Marcus10110/wireless-led-controller/README.md

# wireless-led-pcb

Dirt Simple LED Controller.

ESP32 based.

Supports running from a single 18650 battery, or a barrel jack.

For 18650 operation, only 5V strips are supported.

For barrel jack operation, 5V, 12V, and 24V strips are supported.
