Marcus10110/wireless-led-controller/mech/template_outline.dxf

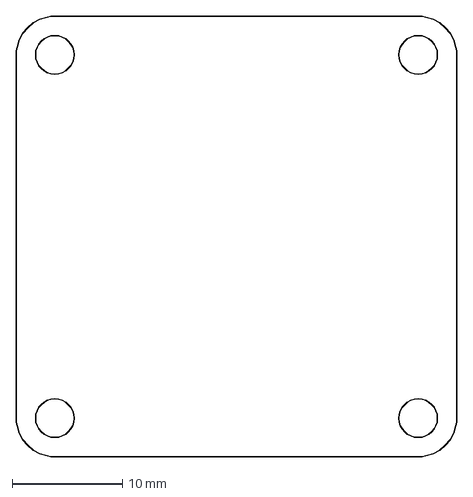
[picture p1: CAD file, 2024-07-03]
mech/template_outline.dxf
40.0 x 40.0 mm
