Marcus10110/wireless-led-controller/mech/template_40x40.dxf

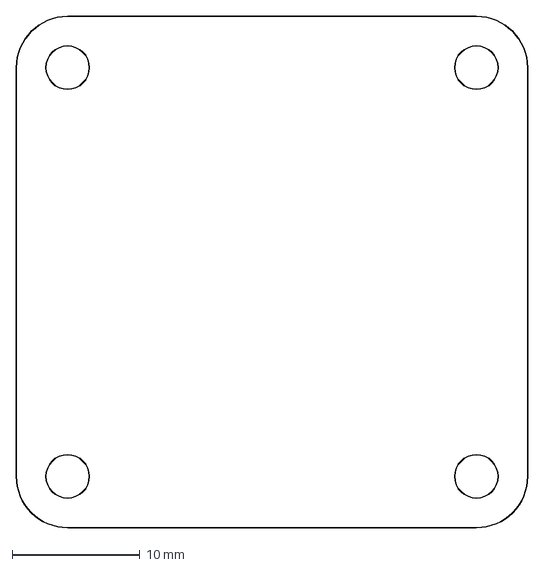
[picture p2: CAD file, 2024-07-03]
mech/template_40x40.dxf
40.0 x 40.0 mm
