Marcus10110/wireless-led-controller/elec/layout/default/wireless-led-pcb.kicad_pcb

## KiCad design elec/layout/default/wireless-led-pcb.kicad_pcb (2024-07-29)

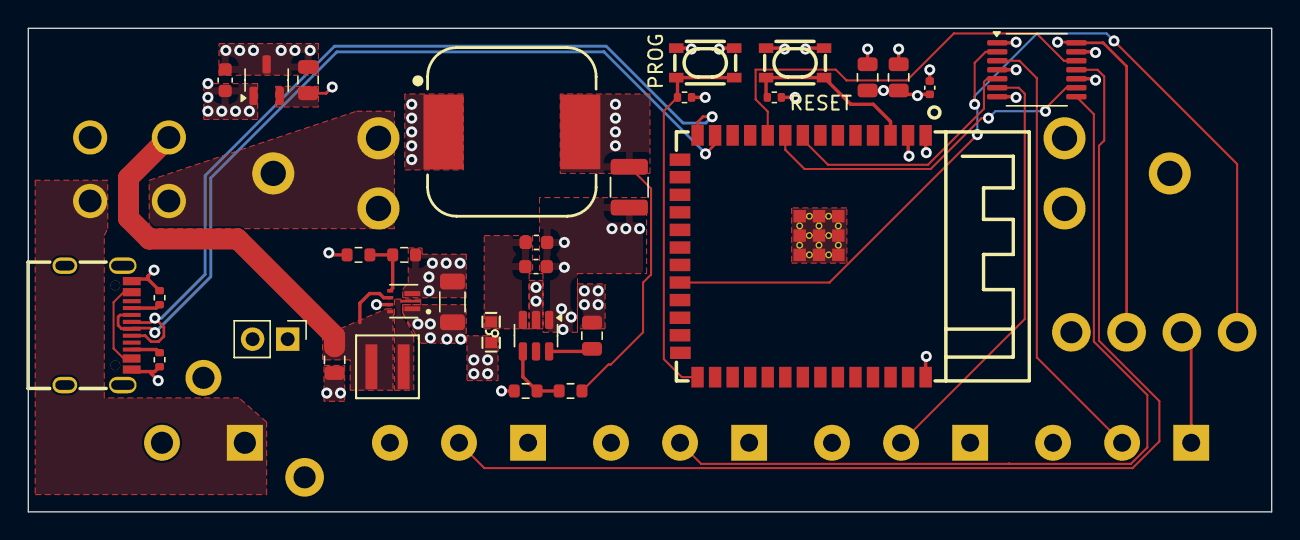
[picture p3: board wireless-led-pcb.kicad_pcb from above]

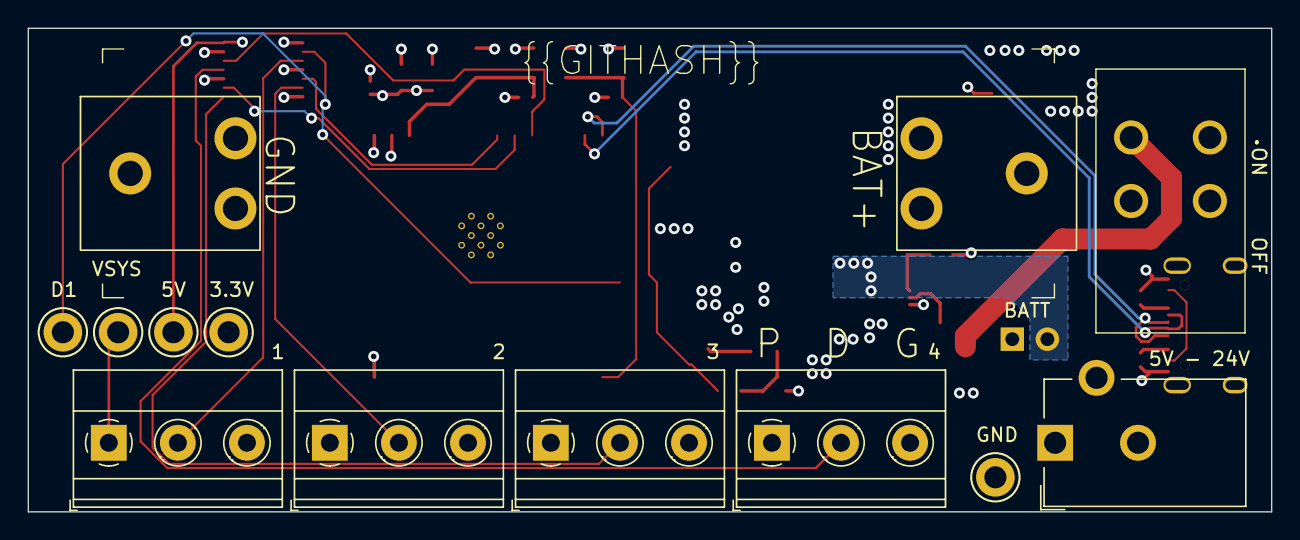
[picture p4: board wireless-led-pcb.kicad_pcb from below]

Board: 4 copper layers, 90.0 x 35.0 mm, 43 parts (12 on the bottom side), 29 nets.

Parts:
C1: 16V 100nF X7R ±10% 0402 Multilayer Ceramic Capaci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; C0402
C2, C3, C4, C11: 25V 10uF X5R ±10% 0805 Multilayer Ceramic Capacit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; C0805
C5: 10V 47uF X5R ±20% 1206 Multilayer Ceramic Capacit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; C1206
C6: 25V 3.3uF X5R ±10% 0603 Multilayer Ceramic Capaci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; C0603
C7: 50V 100nF X7R ±10% 0603 Multilayer Ceramic Capaci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; C0603
C8: 16V 47uF X7R ±10% 1210 Multilayer Ceramic Capacit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; C1210
C9: 50V 100nF X7R ±10% 0805 Multilayer Ceramic Capaci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; C0805
C10: 50V 1uF X5R ±10% 0603 Multilayer Ceramic Capacito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; C0603
J1, J2, J3, J4, J5: TestPoint_Keystone_5005-5009_Compact
L1: 1uH +/- 20%; IND_XAL4020_COC
L2: 10uH +/- 20%; WE-PD_1260
R1, R2: 62.5mW Thick Film Resistors 50V ±100ppm/℃ ±1% 4.7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; R0402
R3, R8: 62.5mW Thick Film Resistors 50V ±100ppm/℃ ±1% 10k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; R0402
R4: 100mW Thick Film Resistors 75V ±100ppm/℃ ±1% 732k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; R0603
R5, R7: 100mW Thick Film Resistors 75V ±100ppm/℃ ±1% 100k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; R0603
R6: 100mW Thick Film Resistors 75V ±100ppm/℃ ±1% 22kΩ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; R0603
U1: USB-C-SMD_KH-TYPE-C-16P
U2: WIRELM-SMD_ESP32-S3-WROOM-1
U3, U17: KEY-SMD_4P-L4.2-W3.2-P2.20-LS4.6
U4: TSSOP-14_4.4x5mm_P0.65mm
U5: Battery-54
U6: BarrelJack_CUI_PJ-102AH_Horizontal
U7, U8, U9, U10: TerminalBlock_Phoenix_MKDS-1,5-3_1x03_P5.00mm_Horizontal
U11: L201011MS02Q
U12: CONV_TPS61022RWUR
U13: SOT-23-6
U14: F0603
U15: PinHeader_1x02_P2.54mm_Vertical
U16: SOT-23-3

Connections:
3V3: C1.1, C2.1, C3.1, C8.1, J2.1, L2.2, R3.1, R7.1, R8.1, U2.2
5V: C5.1, R4.1, U12.3, U15.2
BOOT: R8.2, U2.27, U17.1, U17.2
D_N: U1.A7, U1.B7, U2.13
D_P: U1.A6, U1.B6, U2.14
FB_BOOST: R4.2, R5.1, U12.4
FB_BUCK: R6.1, R7.2, U13.4
GND: C1.2, C2.2, C3.2, C4.2, C5.2, C6.2, C7.2, C8.2, C10.2, C11.2, J1.1, R1.2, R2.2, R5.2, R6.2, U1.1, U1.2, U1.3, U1.4, U1.A1, U1.A12, U1.B1, U1.B12, U2.1, U2.40, U2.41, U3.3, U3.4, U4.1, U4.4, U4.7, U4.10, U4.13, U5.2, U6.2, U7.3, U8.3, U9.3, U10.3, U12.1, U12.6, U13.1, U16.3, U17.3, U17.4
LED1: U4.3, U7.2
LED1_LV: J4.1, U2.22, U4.2
LED2: U4.6, U8.2
LED2_LV: U2.8, U4.5
LED3: U4.8, U9.2
LED3_LV: U2.9, U4.9
LED4: U4.11, U10.2
LED4_LV: U2.10, U4.12
SW_BOOST: L1.2, U12.2
SW_BUCK: C9.2, L2.1, U13.2
V5_LDO: C11.1, J3.1, U4.14, U16.2
VBAT: U5.1, U11.5
VBAT_SW: C4.1, L1.1, U11.4, U12.5, U12.7
VIN_BUCK: C6.1, C7.1, U13.3, U14.2
VJACK: U6.1, U11.2
VSYS: C10.1, J5.1, U7.1, U8.1, U9.1, U10.1, U11.1, U14.1, U15.1, U16.1
boot: C9.1, U13.6
cc1: R1.1, U1.A5
cc2: R2.1, U1.B5
mcu.ic-en: R3.2, U2.3, U3.1, U3.2
vcc: U1.A4, U1.A9, U1.B4, U1.B9
