Marcus10110/wireless-led-controller/(commit log)

2024-07-04 adding footprints (unverified)
2024-07-04 added both switching power supplies, implemented most of the hookup.
2024-07-05 fixed up kicad footprints, added manual footprints for inductors.
2024-07-05 Just started basic component organization in the layout. 1% done.
    [wireless-led-pcb.kicad_pcb]
2024-07-06 lots of little schematic fixes.
2024-07-06 Layout "done" but tbh it's super unverified.
    [wireless-led-pcb.kicad_pcb]
2024-07-07 basic layout complete, smoke tested with jlcpcb.
    [wireless-led-pcb.kicad_pcb]
2024-07-07 added test points
    [wireless-led-pcb.kicad_pcb]
2024-07-07 fixed battery holder footprint to fit longer cell
    [wireless-led-pcb.kicad_pcb]
2024-07-07 removed the high side switch and added a jumper for disconnecting the battery.
    [wireless-led-pcb.kicad_pcb]
2024-07-07 removed extra nest layer.
    [template_40x40.dxf, template_outline.dxf, wireless-led-pcb.kicad_pcb, wireless-led-pcb.kicad_sch]
2024-07-28 added basic test firmware. It works! (until the buck supply exploded)
2024-07-29 added fuse from JLCPCB and new inductor from digikey.
2024-07-29 added net labels added fuse to buck input removed some testpoints. added extra cap to buck supply changed inductor on buck supply to a MUCH larger one.
2024-07-29 totally new layout, much smaller, tons of pours.
    [wireless-led-pcb.kicad_pcb]
